hectorvicario/ROBOT_VICARIO/5_MEDIA/VISTA_LATERAL_IZQUIERDO.jpg

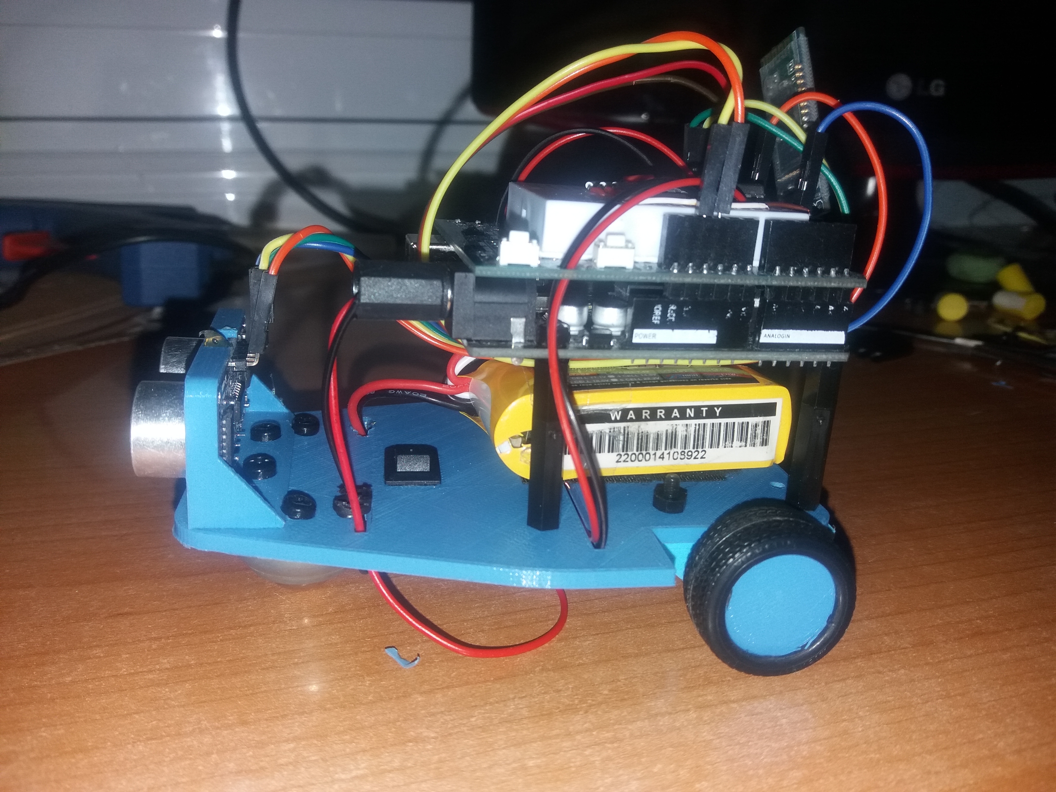
5_MEDIA/VISTA_LATERAL_IZQUIERDO.jpg
