hectorvicario/ROBOT_VICARIO/5_MEDIA/VISTA_FRONTAL.jpg

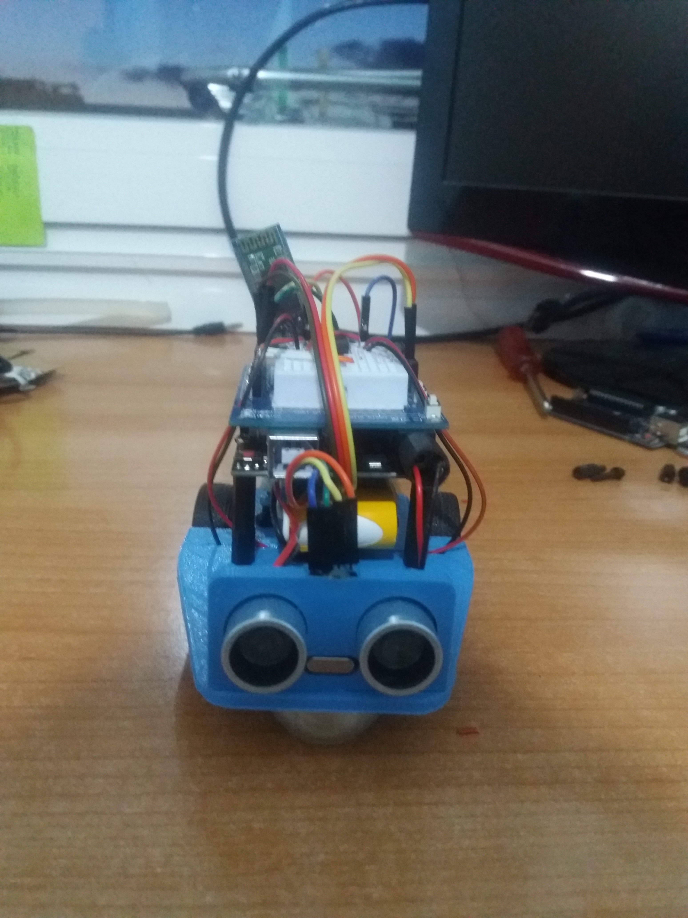
5_MEDIA/VISTA_FRONTAL.jpg
