hectorvicario/ROBOT_VICARIO/5_MEDIA/VISTA_LATERAL_DERECHO.jpg

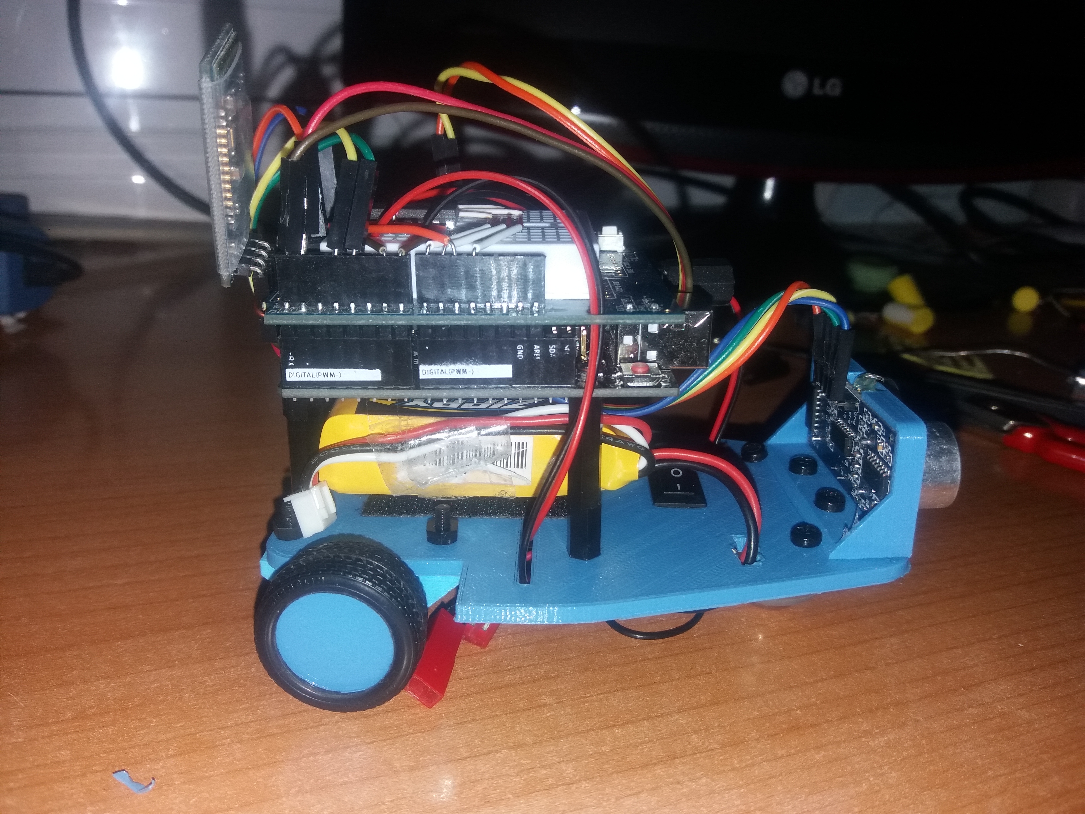
5_MEDIA/VISTA_LATERAL_DERECHO.jpg
