hectorvicario/ROBOT_VICARIO/5_MEDIA/VISTA_TRASERA.jpg

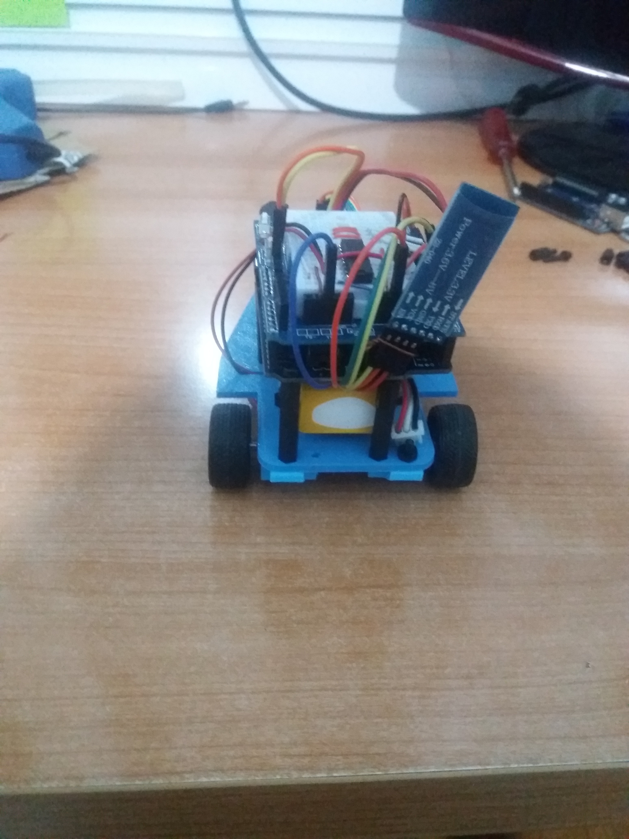
5_MEDIA/VISTA_TRASERA.jpg
