hectorvicario/ROBOT_VICARIO/1_B_O_M/B_O_O_M.xlsx

Sheet: Electronica
COMOPONENTE | UNIDAD | PRECIO | ENLACE
Arduino Uno | 1 | 9.99 € | enlace (https://www.amazon.es/gp/product/B01M7ZB2B4/ref=oh_aui_detailpage_o02_s00?ie=UTF8&psc=1)
Placa shield | 1 | 2.99 € | enlace (https://www.amazon.es/Prototipo-Protoshield-170-Mini-Breadboard-Arduino/dp/B01GCGG770?s=electronics)
Módulo Bluetooth HC-05 | 1 | 3.99 € | enlace (http://www.ebay.es/itm/Modulo-inalambrico-Arduino-HC-06-HC06-Bluetooth-con-base-Slave-W0009/201955035393)
Sensor Ultrasonidos HCSR04 | 1 | 2.25 € | enlace (https://www.amazon.es/Ultrasonidos-Arduino-Medidor-Distancia-Ultrasonico/dp/B075MDMDL2?s=electronics)
Motor con reductora polulu | 2 | 2.21 € | enlace (https://es.aliexpress.com/item/1pc-N20-30-600-1000-1200RPM-DC3-6-12V-Micro-DC-Geared-Motor-Powerful-Electric-Mini/32821265619.html)
Cubierta ruedas | 2 | 0.00 €
Batería LIPO, de 7,4 V (2 celdas) | 1 | 6.68 € | enlace (https://hobbyking.com/en_us/zippy-compact-850mah-2s-25c-lipo-pack.html)
Pulsador | 1 | Kit arduino | enlace (https://www.amazon.es/gp/product/B019GKQ5C6/ref=oh_aui_detailpage_o08_s00?ie=UTF8&psc=1)

Sheet: Mecanica
COMOPONENTE | UNIDAD | PRECIO | ENLACE
Tornillos M3x6mm | 6 | kit tornilleria | enlace (https://www.amazon.es/gp/product/B01MDS2LL4/ref=oh_aui_detailpage_o01_s00?ie=UTF8&psc=1)
Tornillos M3x12mm | 10 | kit tornilleria | enlace (https://www.amazon.es/gp/product/B01MDS2LL4/ref=oh_aui_detailpage_o01_s00?ie=UTF8&psc=1)
Tuercas de M3 | 8 | kit tornilleria | enlace (https://www.amazon.es/gp/product/B01MDS2LL4/ref=oh_aui_detailpage_o01_s00?ie=UTF8&psc=1)
Separadores hexagonales | 8 | kit tornilleria | enlace (https://www.amazon.es/gp/product/B01MDS2LL4/ref=oh_aui_detailpage_o01_s00?ie=UTF8&psc=1)
kit tornilleria |  | 9.60 € | enlace (https://www.amazon.es/gp/product/B01MDS2LL4/ref=oh_aui_detailpage_o01_s00?ie=UTF8&psc=1)

Sheet: Piezas 3D
Pieza | UNIDAD | IMAGEN
Base | 1
Ruedas | 2
Soporte motor | 2
Soporte ultrasonidos | 1
