hectorvicario/ROBOT_VICARIO/3_3D_PIEZAS/PIEZAS_FORMATO_FCStd/RUEDA.FCStd

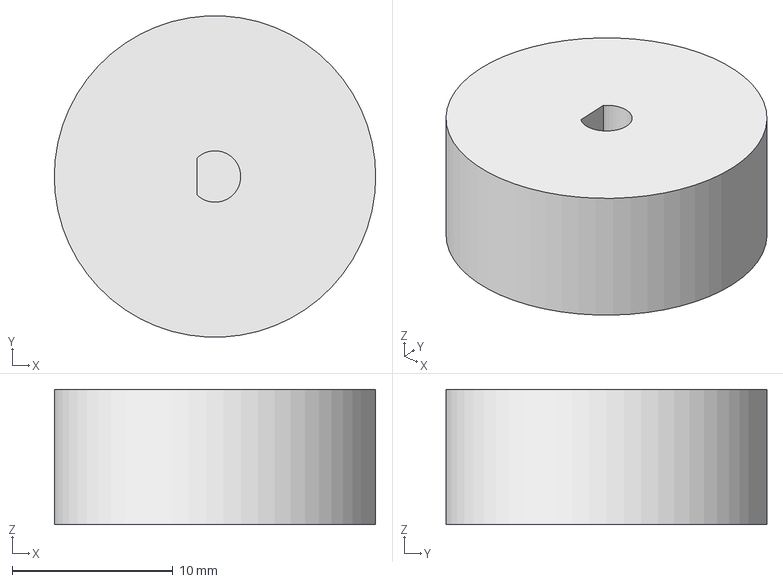
[picture p7: CAD file, 2018-03-23]
3_3D_PIEZAS/PIEZAS_FORMATO_FCStd/RUEDA.FCStd
20.0 x 20.0 x 8.40 mm
