hectorvicario/ROBOT_VICARIO/3_3D_PIEZAS/PIEZAS_FORMATO_FCStd/SOPORTE_MOTOR_POLULU.FCStd

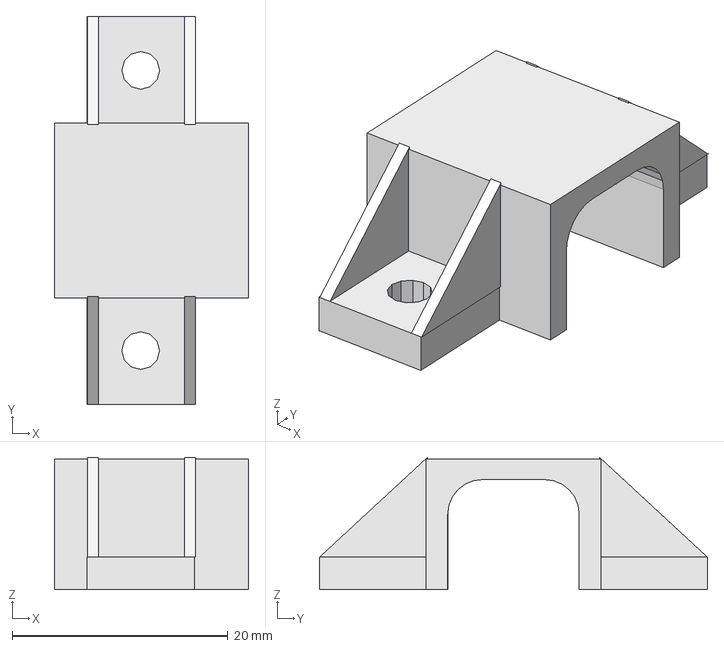
[picture p8: CAD file, 2018-03-23]
3_3D_PIEZAS/PIEZAS_FORMATO_FCStd/SOPORTE_MOTOR_POLULU.FCStd
18.0 x 36.0 x 12.3 mm
