hectorvicario/ROBOT_VICARIO/3_3D_PIEZAS/PIEZAS_FORMATO_FCStd/SOPORTE_ULTRASONIDOS.FCStd

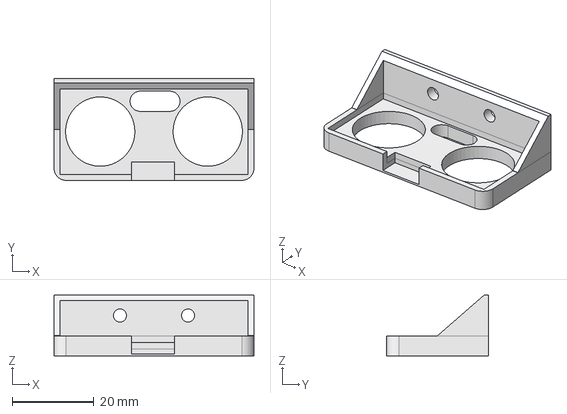
[picture p9: CAD file, 2018-03-23]
3_3D_PIEZAS/PIEZAS_FORMATO_FCStd/SOPORTE_ULTRASONIDOS.FCStd
49.0 x 25.0 x 14.9 mm
