hectorvicario/ROBOT_VICARIO/3_3D_PIEZAS/PIEZAS_FORMATO_FCStd/BASE_ROBOT.FCStd

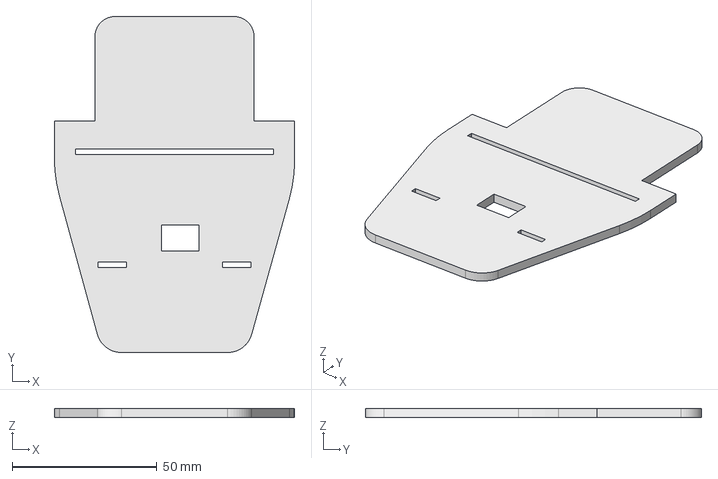
[picture p10: CAD file, 2018-03-23]
3_3D_PIEZAS/PIEZAS_FORMATO_FCStd/BASE_ROBOT.FCStd
83.0 x 116.0 x 3.00 mm
