hectorvicario/ROBOT_VICARIO/(list of files, cad)

Other CAD files:
3_3D_PIEZAS/PIEZAS_FORMATO_STL/BASE_ROBOT.stl
3_3D_PIEZAS/PIEZAS_FORMATO_STL/RUEDA.stl
3_3D_PIEZAS/PIEZAS_FORMATO_STL/SOPORTE_MOTOR_POLULU.stl
3_3D_PIEZAS/PIEZAS_FORMATO_STL/SOPORTE_ULTRASONIDOS.stl
