hectorvicario/ROBOT_VICARIO/5_MEDIA/PLANTA.jpg

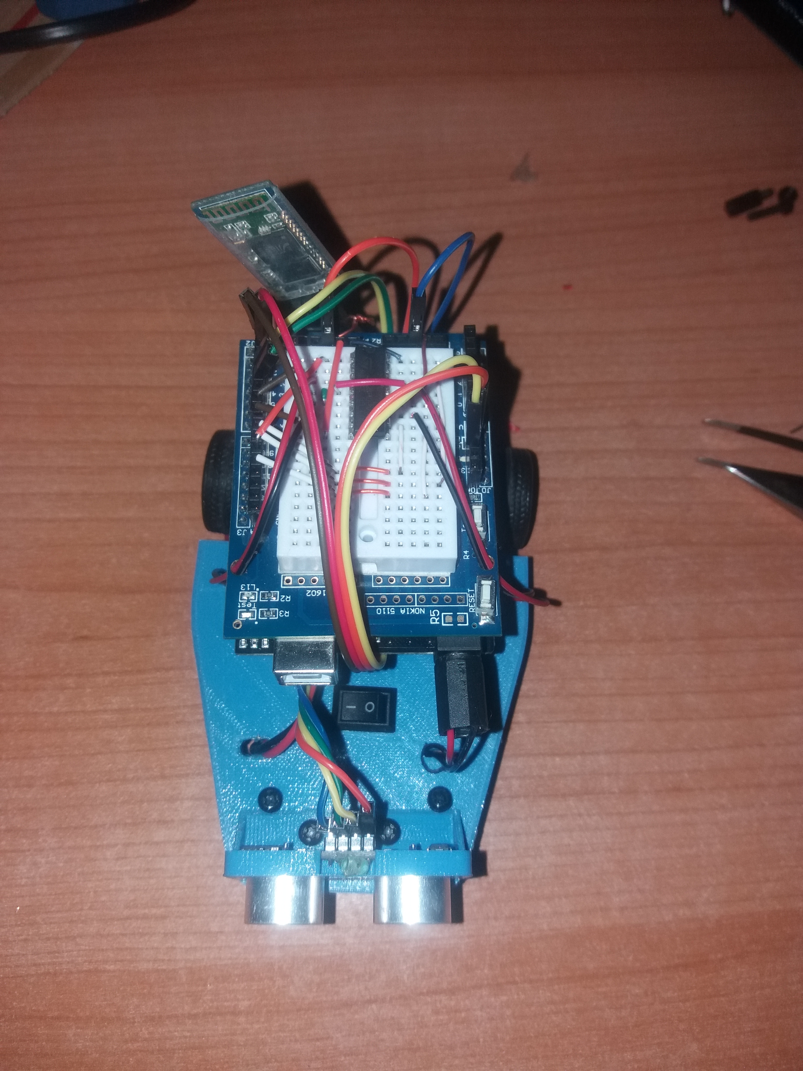
5_MEDIA/PLANTA.jpg
