hectorvicario/ROBOT_VICARIO/1_B_O_M/DESPIECE.jpg

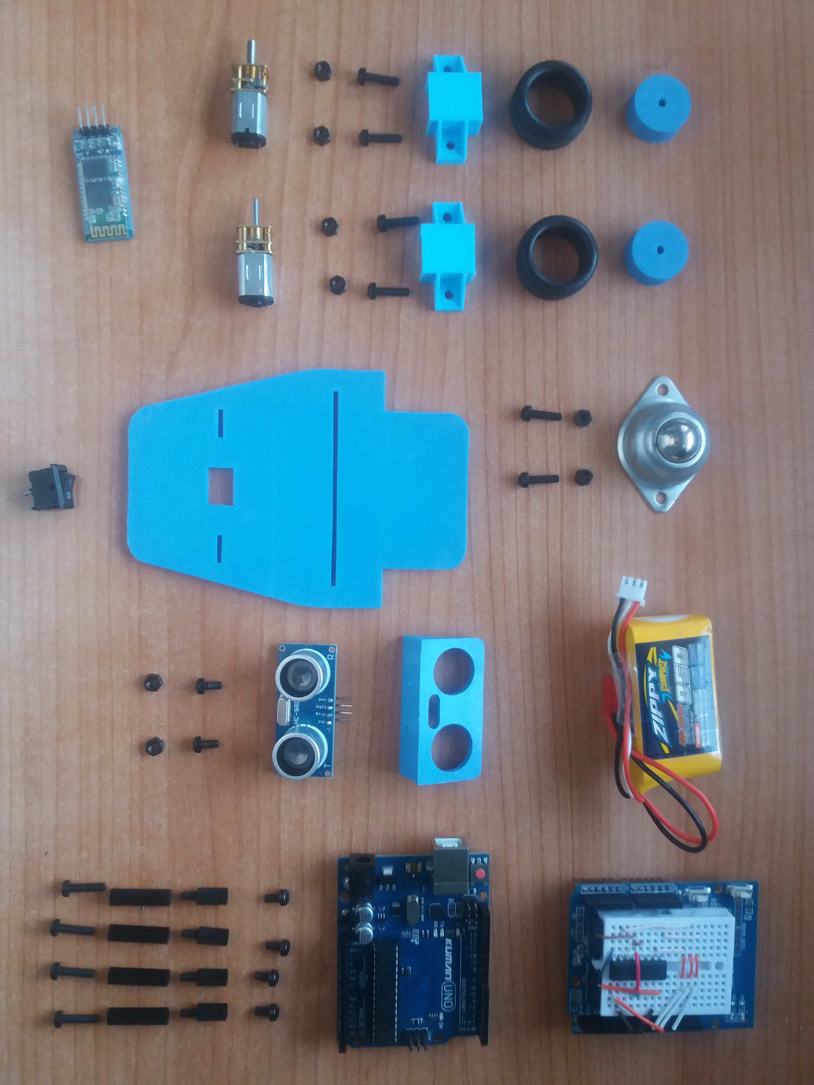
1_B_O_M/DESPIECE.jpg
